Alan00662/Ultra_Port_Board/LVGL_ext/readme.txt

程序运行在外部nor flash，需先下载boot到单片机oader，再烧写本程序，最后再给板子重新上电。
