Alan00662/Ultra_Port_Board/LVGL_MDK_TouchGFX/Core/Src/main.c

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
/* Includes ------------------------------------------------------------------*/
#include "main.h"
#include "cmsis_os.h"
#include "crc.h"
#include "dma2d.h"
#include "fdcan.h"
#include "i2c.h"
#include "ltdc.h"
#include "memorymap.h"
#include "spi.h"
#include "tim.h"
#include "usart.h"
#include "usb_otg.h"
#include "gpio.h"
#include "app_touchgfx.h"

/* USER CODE BEGIN Includes */
#include "lcd.h"
#include "gt911.h"
#include "stdio.h"
#include "ring_buffer.h"

/* USER CODE END Includes */


void SystemClock_Config(void);
void MX_FREERTOS_Init(void);
/* USER CODE BEGIN 0 */
#ifdef __GNUC__
#define PUTCHAR_PROTOTYPE int __io_putchar(int ch)
#else
#define PUTCHAR_PROTOTYPE int fputc(int ch, FILE *f)
#endif
PUTCHAR_PROTOTYPE
{
    HAL_UART_Transmit(&huart1 , (uint8_t *)&ch, 1, 0xFFFF);
    return ch;
}

//ring buffer
#define BUFFER_SIZE 1024
static uint8_t buffer[BUFFER_SIZE];
uint8_t rx_buffer=0;
ring_buffer rb;

void MPU_Config(void);
	
/* USER CODE END 0 */

/**
  * @brief  The application entry point.
  * @retval int
  */
int main(void)
{

  /* USER CODE BEGIN 1 */
	MPU_Config();
  SCB->CACR|=1<<2;
  /* USER CODE END 1 */

  /* Enable the CPU Cache */

  /* Enable I-Cache---------------------------------------------------------*/
  SCB_EnableICache();

  /* Enable D-Cache---------------------------------------------------------*/
  SCB_EnableDCache();

  /* MCU Configuration--------------------------------------------------------*/

  /* Reset of all peripherals, Initializes the Flash interface and the Systick. */
  HAL_Init();

  /* Configure the system clock */
  SystemClock_Config();

  /* Initialize all configured peripherals */
  MX_GPIO_Init();
//  MX_FDCAN1_Init();
  MX_LTDC_Init();
  MX_USART1_UART_Init();
  MX_I2C3_Init();
  MX_SPI1_Init();
  MX_USART2_UART_Init();
  MX_I2C4_Init();
  MX_DMA2D_Init();
  MX_CRC_Init();
  MX_SPI4_Init();
//  MX_USB_OTG_FS_PCD_Init();
//  MX_USB_OTG_HS_HCD_Init();
  MX_TIM6_Init();
  MX_TouchGFX_Init();
  /* Call PreOsInit function */
  MX_TouchGFX_PreOSInit();
  /* USER CODE BEGIN 2 */
	HAL_Delay(10);
	lcd_init();
	RB_Init(&rb,buffer,BUFFER_SIZE);
	HAL_TIM_Base_Start_IT(&htim6);
  /* USER CODE END 2 */

  /* Init scheduler */
  osKernelInitialize();

  /* Call init function for freertos objects (in cmsis_os2.c) */
  MX_FREERTOS_Init();

  /* Start scheduler */
  osKernelStart();

  /* We should never get here as control is now taken by the scheduler */

  /* Infinite loop */
  /* USER CODE BEGIN WHILE */
  while (1)
  {
    /* USER CODE END WHILE */

    /* USER CODE BEGIN 3 */
  }
  /* USER CODE END 3 */
}

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
/* USER CODE BEGIN 4 */
void HAL_UART_RxCpltCallback(UART_HandleTypeDef *huart)
{
	RB_Write_Byte(&rb,rx_buffer);
	HAL_UART_Receive_IT(&huart1,&rx_buffer,1);
}

void MPU_Config(void)
{
    MPU_Region_InitTypeDef MPU_InitStruct={0};

    HAL_MPU_Disable();

    MPU_InitStruct.Enable 				= MPU_REGION_ENABLE;
    MPU_InitStruct.BaseAddress 		    = 0x24000000;
    MPU_InitStruct.Size 				= MPU_REGION_SIZE_512KB;
    MPU_InitStruct.AccessPermission 	= MPU_REGION_FULL_ACCESS;
    MPU_InitStruct.IsBufferable 		= MPU_ACCESS_NOT_BUFFERABLE;
    MPU_InitStruct.IsCacheable 		    = MPU_ACCESS_CACHEABLE;
    MPU_InitStruct.IsShareable 		    = MPU_ACCESS_NOT_SHAREABLE;
    MPU_InitStruct.Number 				= MPU_REGION_NUMBER0;
    MPU_InitStruct.TypeExtField 		= MPU_TEX_LEVEL0;
    MPU_InitStruct.SubRegionDisable 	= 0x00;
    MPU_InitStruct.DisableExec 		    = MPU_INSTRUCTION_ACCESS_ENABLE;

    HAL_MPU_ConfigRegion(&MPU_InitStruct);


    HAL_MPU_Enable(MPU_PRIVILEGED_DEFAULT);
}

/* USER CODE END 4 */

/**
  * @brief  Period elapsed callback in non blocking mode
  * @note   This function is called  when TIM7 interrupt took place, inside
  * HAL_TIM_IRQHandler(). It makes a direct call to HAL_IncTick() to increment
  * a global variable "uwTick" used as application time base.
  * @param  htim : TIM handle
  * @retval None
  */
void HAL_TIM_PeriodElapsedCallback(TIM_HandleTypeDef *htim)
{
  if (htim->Instance == TIM7) {
    HAL_IncTick();
  }
  /* USER CODE BEGIN Callback 1 */
	else if(htim->Instance == TIM6)
	{

	}
  /* USER CODE END Callback 1 */
}

/**
  * @brief  This function is executed in case of error occurrence.
  * @retval None
  */
void Error_Handler(void)
{
  /* USER CODE BEGIN Error_Handler_Debug */
  /* User can add his own implementation to report the HAL error return state */
  __disable_irq();
  while (1)
  {
  }
  /* USER CODE END Error_Handler_Debug */
}

#ifdef  USE_FULL_ASSERT
/**
  * @brief  Reports the name of the source file and the source line number
  *         where the assert_param error has occurred.
  * @param  file: pointer to the source file name
  * @param  line: assert_param error line source number
  * @retval None
  */
void assert_failed(uint8_t *file, uint32_t line)
{
  /* USER CODE BEGIN 6 */
  /* User can add his own implementation to report the file name and line number,
     ex: printf("Wrong parameters value: file %s on line %d\r\n", file, line) */
  /* USER CODE END 6 */
}
#endif /* USE_FULL_ASSERT */
