Alan00662/Ultra_Port_Board/Cmake_App/Cmake_App.ioc

Mcu.UserName=STM32H750VBTx
PA0.GPIO_Label=GPIO1
PA0.Signal=GPIO_Output
PA1.GPIO_Label=BAT_VOLT
PA1.Signal=ADC1_INP17
PA10.Signal=USART1_RX
PA11.Signal=USB_OTG_FS_DM
PA12.Signal=USB_OTG_FS_DP
PA3.Signal=LTDC_B5
PA4.Signal=LTDC_VSYNC
PA5.Signal=LTDC_R4
PA6.Signal=LTDC_G2
PA8.Signal=I2C3_SCL
PA9.Signal=USART1_TX
PB0.Signal=LTDC_R3
PB1.Signal=LTDC_R6
PB10.Signal=LTDC_G4
PB11.Signal=LTDC_G5
PB12.GPIO_Label=LED_R
PB12.Signal=GPIO_Output
PB13.GPIO_Label=LED_G
PB13.Signal=GPIO_Output
PB14.Signal=USB_OTG_HS_DM
PB15.Signal=USB_OTG_HS_DP
PB2.Signal=QUADSPI_CLK
PB5.Signal=GPIO_Output
PB6.GPIO_Label=LCD_BL
PB6.Signal=GPIO_Output
PB8.Signal=LTDC_B6
PB9.Signal=LTDC_B7
PC0.Signal=LTDC_R5
PC11.Signal=QUADSPI_BK2_NCS
PC12.Signal=SDMMC1_CK
PC5.GPIO_Label=TF_DETECT
PC5.Signal=GPIO_Input
PC6.Signal=LTDC_HSYNC
PC7.Signal=LTDC_G6
PC8.Signal=SDMMC1_D0
PC9.Signal=I2C3_SDA
PD0.Signal=FDCAN1_RX
PD1.Signal=FDCAN1_TX
PD10.Signal=LTDC_B3
PD12.Signal=I2C4_SCL
PD13.Signal=I2C4_SDA
PD14.GPIO_Label=TP_RST
PD14.Signal=GPIO_Output
PD15.GPIO_Label=TP_INT
PD15.Signal=GPIO_Input
PD2.Signal=SDMMC1_CMD
PD3.Signal=LTDC_G7
PD4.Signal=USART2_DE
PD5.Signal=USART2_TX
PD6.Signal=USART2_RX
PE0.GPIO_Label=PWR
PE0.Signal=GPIO_Output
PE1.GPIO_Label=BTN_UP
PE1.Signal=GPIO_Input
PE10.Signal=QUADSPI_BK2_IO3
PE11.Signal=LTDC_G3
PE12.Signal=LTDC_B4
PE13.Signal=LTDC_DE
PE14.Signal=LTDC_CLK
PE15.Signal=LTDC_R7
PE2.Signal=SPI4_SCK
PE3.GPIO_Label=LCD_RST
PE3.Signal=GPIO_Output
PE4.GPIO_Label=LCD_CS
PE4.Signal=GPIO_Output
PE5.Signal=SPI4_MISO
PE6.Signal=SPI4_MOSI
PE7.Signal=QUADSPI_BK2_IO0
PE8.Signal=QUADSPI_BK2_IO1
PE9.Signal=QUADSPI_BK2_IO2
