Alan00662/Ultra_Port_Board/Cmake_App/Core/Inc/main.h

#define LCD_RST_Pin GPIO_PIN_3
#define LCD_RST_GPIO_Port GPIOE
#define LCD_CS_Pin GPIO_PIN_4
#define LCD_CS_GPIO_Port GPIOE
#define GPIO1_Pin GPIO_PIN_0
#define GPIO1_GPIO_Port GPIOA
#define BAT_VOLT_Pin GPIO_PIN_1
#define BAT_VOLT_GPIO_Port GPIOA
#define TF_DETECT_Pin GPIO_PIN_5
#define TF_DETECT_GPIO_Port GPIOC
#define LED_R_Pin GPIO_PIN_12
#define LED_R_GPIO_Port GPIOB
#define LED_G_Pin GPIO_PIN_13
#define LED_G_GPIO_Port GPIOB
#define TP_RST_Pin GPIO_PIN_14
#define TP_RST_GPIO_Port GPIOD
#define TP_INT_Pin GPIO_PIN_15
#define TP_INT_GPIO_Port GPIOD
#define LCD_BL_Pin GPIO_PIN_6
#define LCD_BL_GPIO_Port GPIOB
#define PWR_Pin GPIO_PIN_0
#define PWR_GPIO_Port GPIOE
#define BTN_UP_Pin GPIO_PIN_1
#define BTN_UP_GPIO_Port GPIOE
