Alan00662/Ultra_Port_Board/(commit log)

2025-01-18 添加下载算法
2025-01-18 添加bootloader
2025-01-18 修复QSPI初始化没有选择正确的ID
2025-03-18 添加 ＬＶＧＬ ｓｗｉｔｃｈ例程
2025-04-03 添加CubePro的下载算法工程
2025-04-03 Rename Keil_FLM下载算法
2025-04-03 添加说明图片
2025-04-03 删除一些无用的驱动
2026-02-05 添加lvgl工程
2026-02-10 feat:添加bootlaoder工程
2026-02-10 update driver
2026-02-10 删除 不必要的驱动
