Alan00662/Ultra_Port_Board/(notices)

Notices in the files:
Cmake_App/Core/Inc/main.h:
Copyright (c) 2026 STMicroelectronics.
All rights reserved.
This software is licensed under terms that can be found in the LICENSE file
LVGL_MDK_TouchGFX/Core/Src/main.c:
Copyright (c) 2024 STMicroelectronics.
